NU-Horizonsat/debug_board/debug_board.kicad_pcb

## KiCad design debug_board.kicad_pcb (2024-07-23)

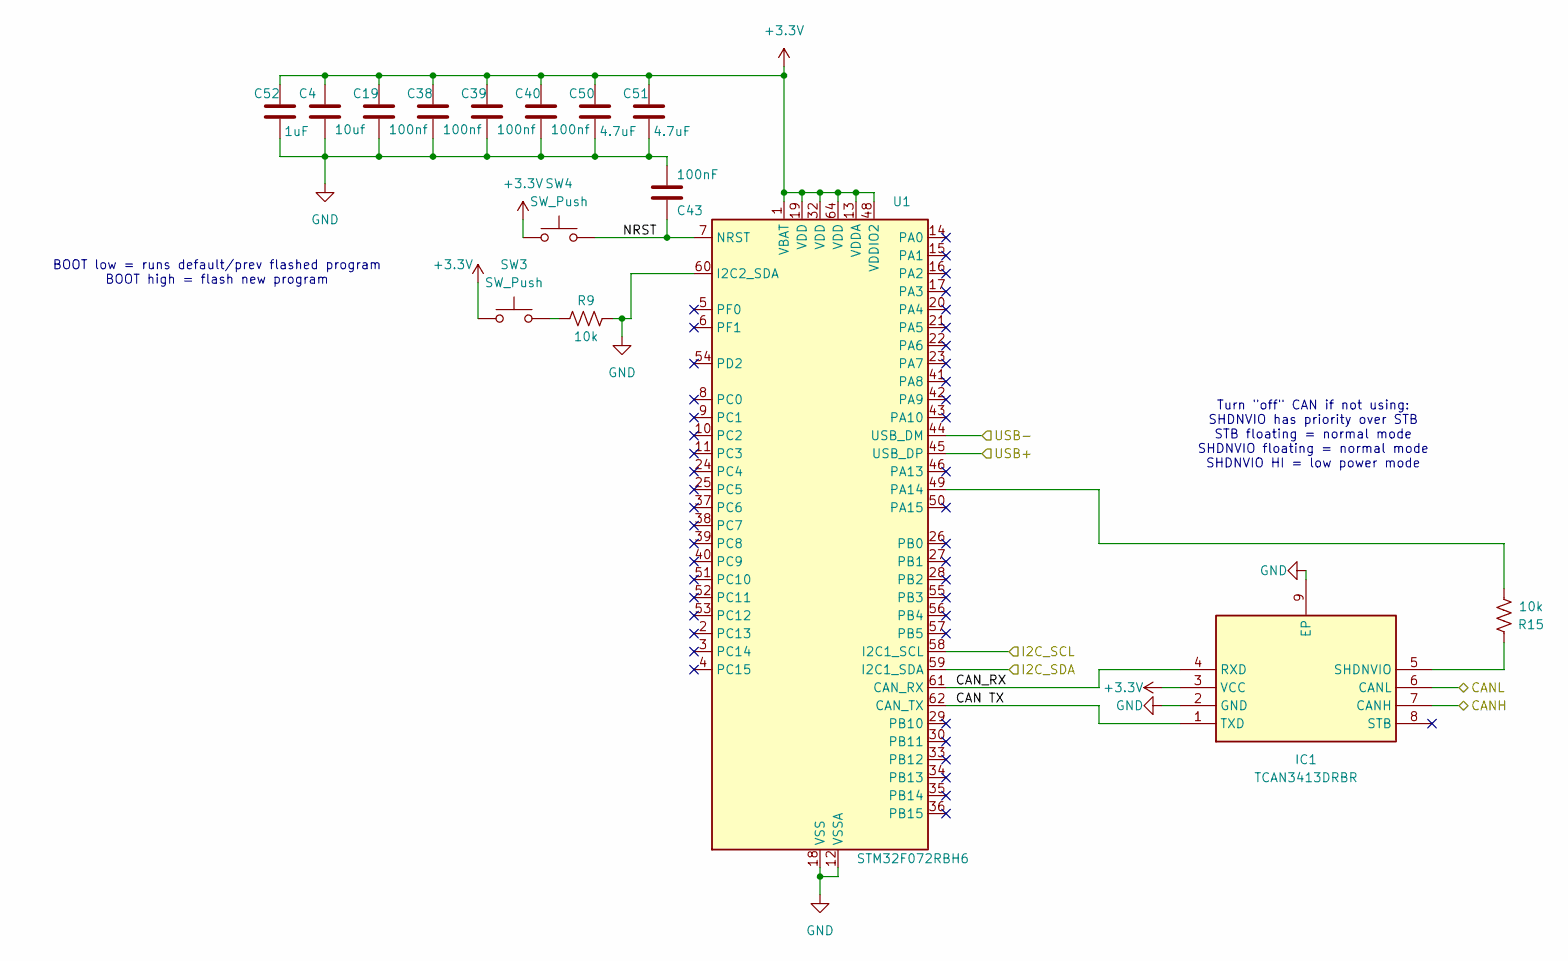
[picture p1: schematic STM32.kicad_sch]

Parts:
C4: 10uf; C_0603_1608Metric
C19, C38, C39, C40: 100nf; C_0603_1608Metric
C43: 100nF; C_0603_1608Metric
C50, C51: 4.7uF; C_0603_1608Metric
C52: 1uF; C_0603_1608Metric
IC1: TCAN3413DRBR; SON65P300X300X100-9N-D; Mouser Part Number 595-TCAN3413DRBR
R9, R15: 10k; R_0603_1608Metric
SW3, SW4: SW_Push; SW_Push_1P1T_XKB_TS-1187A
U1: STM32F072RBH6; LQFP-64_10x10mm_P0.5mm

Connections:
+3.3V: C4.1, C19.1, C38.1, C39.1, C40.1, C50.1, C51.1, C52.1, IC1.3 (VCC), SW3.1, SW4.1, U1.1 (VBAT), U1.13 (VDDA), U1.19 (VDD), U1.32 (VDD), U1.48 (VDDIO2), U1.64 (VDD); also elsewhere on the board
/Connector/CANH: IC1.7 (CANH); also elsewhere on the board
/Connector/CANL: IC1.6 (CANL); also elsewhere on the board
/Connector/I2C_SCL: U1.58 (I2C1_SCL); also elsewhere on the board
/Connector/I2C_SDA: U1.59 (I2C1_SDA); also elsewhere on the board
/STM32/CAN TX: IC1.1 (TXD), U1.62 (CAN_TX)
/STM32/CAN_RX: IC1.4 (RXD), U1.61 (CAN_RX)
/STM32/NRST: C43.2, SW4.2, U1.7 (NRST)
/STM32/USB+: U1.45 (USB_DP); also elsewhere on the board
/STM32/USB-: U1.44 (USB_DM); also elsewhere on the board
GND: C4.2, C19.2, C38.2, C39.2, C40.2, C43.1, C50.2, C51.2, C52.2, IC1.2 (GND), IC1.9 (EP), R9.2, U1.12 (VSSA), U1.18 (VSS), U1.31 (VSS), U1.47 (VSS), U1.60 (I2C2_SDA), U1.63 (VSS); also elsewhere on the board
unnamed: IC1.5 (SHDNVIO), R15.2
unnamed: R9.1, SW3.2
unnamed: R15.1, U1.49 (PA14)

Notes on the sheet:
BOOT low = runs default/prev flashed program BOOT high = flash new program
Turn "off" CAN if not using: SHDNVIO has priority over STB STB floating = normal mode SHDNVIO floating = normal mode SHDNVIO HI = low power mode

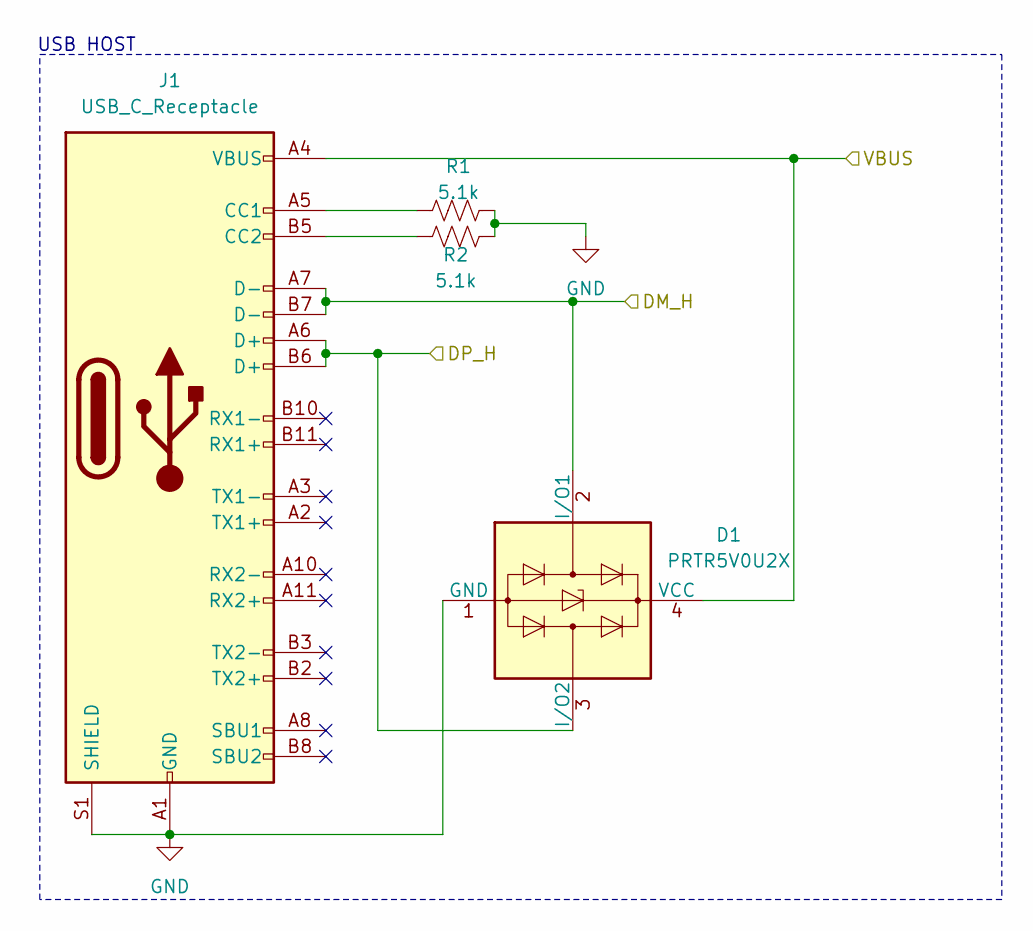
[picture p2: schematic host.kicad_sch]

Parts:
D1: PRTR5V0U2X; SOT-143
J1: USB_C_Receptacle; USB_C_Receptacle_HRO_TYPE-C-31-M-12
R1, R2: 5.1k; R_0603_1608Metric

Connections:
/USB Host/DM_H: D1.2 (I/O1), J1.A7 (D-), J1.B7 (D-); also elsewhere on the board
/USB Host/DP_H: D1.3 (I/O2), J1.A6 (D+), J1.B6 (D+); also elsewhere on the board
/USB Host/VBUS: D1.4 (VCC), J1.A4 (VBUS), J1.A9 (VBUS), J1.B4 (VBUS), J1.B9 (VBUS); also elsewhere on the board
GND: D1.1 (GND), J1.A1 (GND), J1.A12 (GND), J1.B1 (GND), J1.B12 (GND), J1.S1 (SHIELD), R1.2, R2.2; also elsewhere on the board
unnamed: J1.A5 (CC1), R1.1
unnamed: J1.B5 (CC2), R2.1

Notes on the sheet:
USB HOST

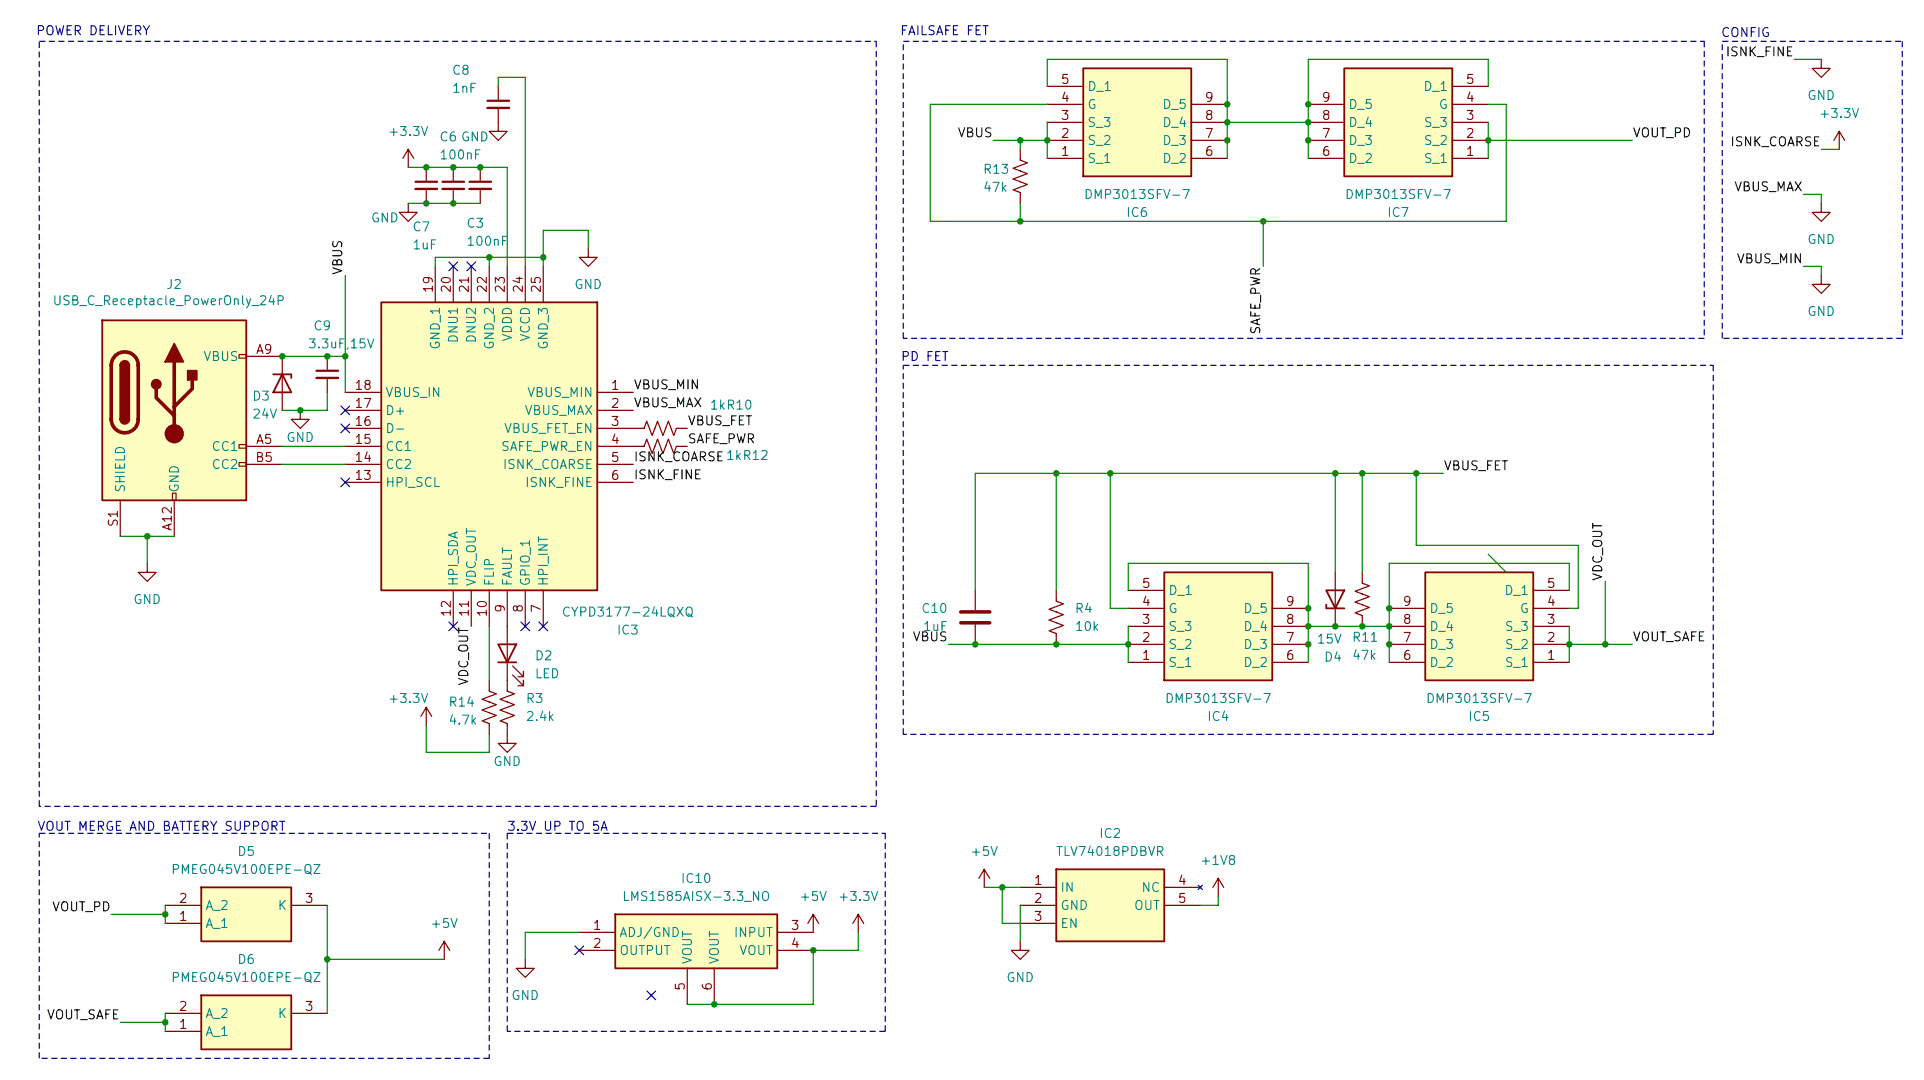
[picture p3: schematic power.kicad_sch]

Parts:
C3, C6: 100nF; C_0603_1608Metric
C7, C10: 1uF; C_0603_1608Metric
C8: 1nF; C_0603_1608Metric
C9: 3.3uF,15V; C_0603_1608Metric
D2: LED; LED_0603_1608Metric
D3: 24V; D_SOD-323_HandSoldering
D4: 15V; SODFL2513X100N
D5, D6: PMEG045V100EPE-QZ; PMEG045V100EPEQZ; Mouser Part Number 771-PMEG045V100EPEQZ
IC2: TLV74018PDBVR; SOT95P280X145-5N; Mouser Part Number 595-TLV74018PDBVR
IC3: CYPD3177-24LQXQ; QFN50P400X400X60-25N-D; Mouser Part Number 727-CYPD3177-24LQXQ
IC4, IC5, IC6, IC7: DMP3013SFV-7; DMP3036SFV7; Mouser Part Number 621-DMP3013SFV-7
IC10: LMS1585AISX-3.3_NO; KTT0003B; Mouser Part Number 595-LMS1585AISX33/NO
J2: USB_C_Receptacle_PowerOnly_24P; USB_C_Receptacle_GCT_USB4135-GF-A_6P_TopMnt_Horizontal
R3: 2.4k; R_0603_1608Metric
R4: 10k; R_0603_1608Metric
R10, R12: 1k; R_0603_1608Metric
R11, R13: 47k; R_0603_1608Metric
R14: 4.7k; R_0603_1608Metric

Connections:
+1V8: IC2.5 (OUT); also elsewhere on the board
+3.3V: C3.1, C6.1, C7.1, IC3.5 (ISNK_COARSE), IC3.23 (VDDD), IC10.4 (VOUT), IC10.5 (VOUT), IC10.6 (VOUT), R14.2; also elsewhere on the board
+5V: D5.3 (K), D6.3 (K), IC2.1 (IN), IC2.3 (EN), IC10.3 (INPUT); also elsewhere on the board
/Power/SAFE_PWR: IC6.4 (G), IC7.4 (G), R12.2, R13.2
/Power/VBUS: C9.1, C10.2, D3.1 (K), IC3.18 (VBUS_IN), IC4.1 (S_1), IC4.2 (S_2), IC4.3 (S_3), IC6.1 (S_1), IC6.2 (S_2), IC6.3 (S_3), J2.A4 (VBUS), J2.A9 (VBUS), J2.B4 (VBUS), J2.B9 (VBUS), R4.2, R13.1
/Power/VBUS_FET: C10.1, D4.2 (A), IC4.4 (G), IC5.4 (G), R4.1, R10.2, R11.1
/Power/VDC_OUT: D6.1 (A_1), D6.2 (A_2), IC3.11 (VDC_OUT), IC5.1 (S_1), IC5.2 (S_2), IC5.3 (S_3)
/Power/VOUT_PD: D5.1 (A_1), D5.2 (A_2), IC7.1 (S_1), IC7.2 (S_2), IC7.3 (S_3)
GND: C3.2, C6.2, C7.2, C8.2, C9.2, D3.2 (A), IC2.2 (GND), IC3.1 (VBUS_MIN), IC3.2 (VBUS_MAX), IC3.6 (ISNK_FINE), IC3.19 (GND_1), IC3.22 (GND_2), IC3.25 (GND_3), IC10.1 (ADJ/GND), J2.A1 (GND), J2.A12 (GND), J2.B1 (GND), J2.B12 (GND), J2.S1 (SHIELD), R3.2; also elsewhere on the board
unnamed: D2.2 (A), IC3.9 (FAULT)
unnamed: D2.1 (K), R3.1
unnamed: D4.1 (K), IC4.5 (D_1), IC4.6 (D_2), IC4.7 (D_3), IC4.8 (D_4), IC4.9 (D_5), IC5.5 (D_1), IC5.6 (D_2), IC5.7 (D_3), IC5.8 (D_4), IC5.9 (D_5), R11.2
unnamed: IC3.15 (CC1), J2.A5 (CC1)
unnamed: IC3.14 (CC2), J2.B5 (CC2)
unnamed: IC3.10 (FLIP), R14.1
unnamed: IC3.4 (SAFE_PWR_EN), R12.1
unnamed: IC3.3 (VBUS_FET_EN), R10.1
unnamed: C8.1, IC3.24 (VCCD)
unnamed: IC6.5 (D_1), IC6.6 (D_2), IC6.7 (D_3), IC6.8 (D_4), IC6.9 (D_5), IC7.5 (D_1), IC7.6 (D_2), IC7.7 (D_3), IC7.8 (D_4), IC7.9 (D_5)

Notes on the sheet:
PD FET
POWER DELIVERY
VOUT MERGE AND BATTERY SUPPORT
CONFIG
3.3V UP TO 5A
FAILSAFE FET

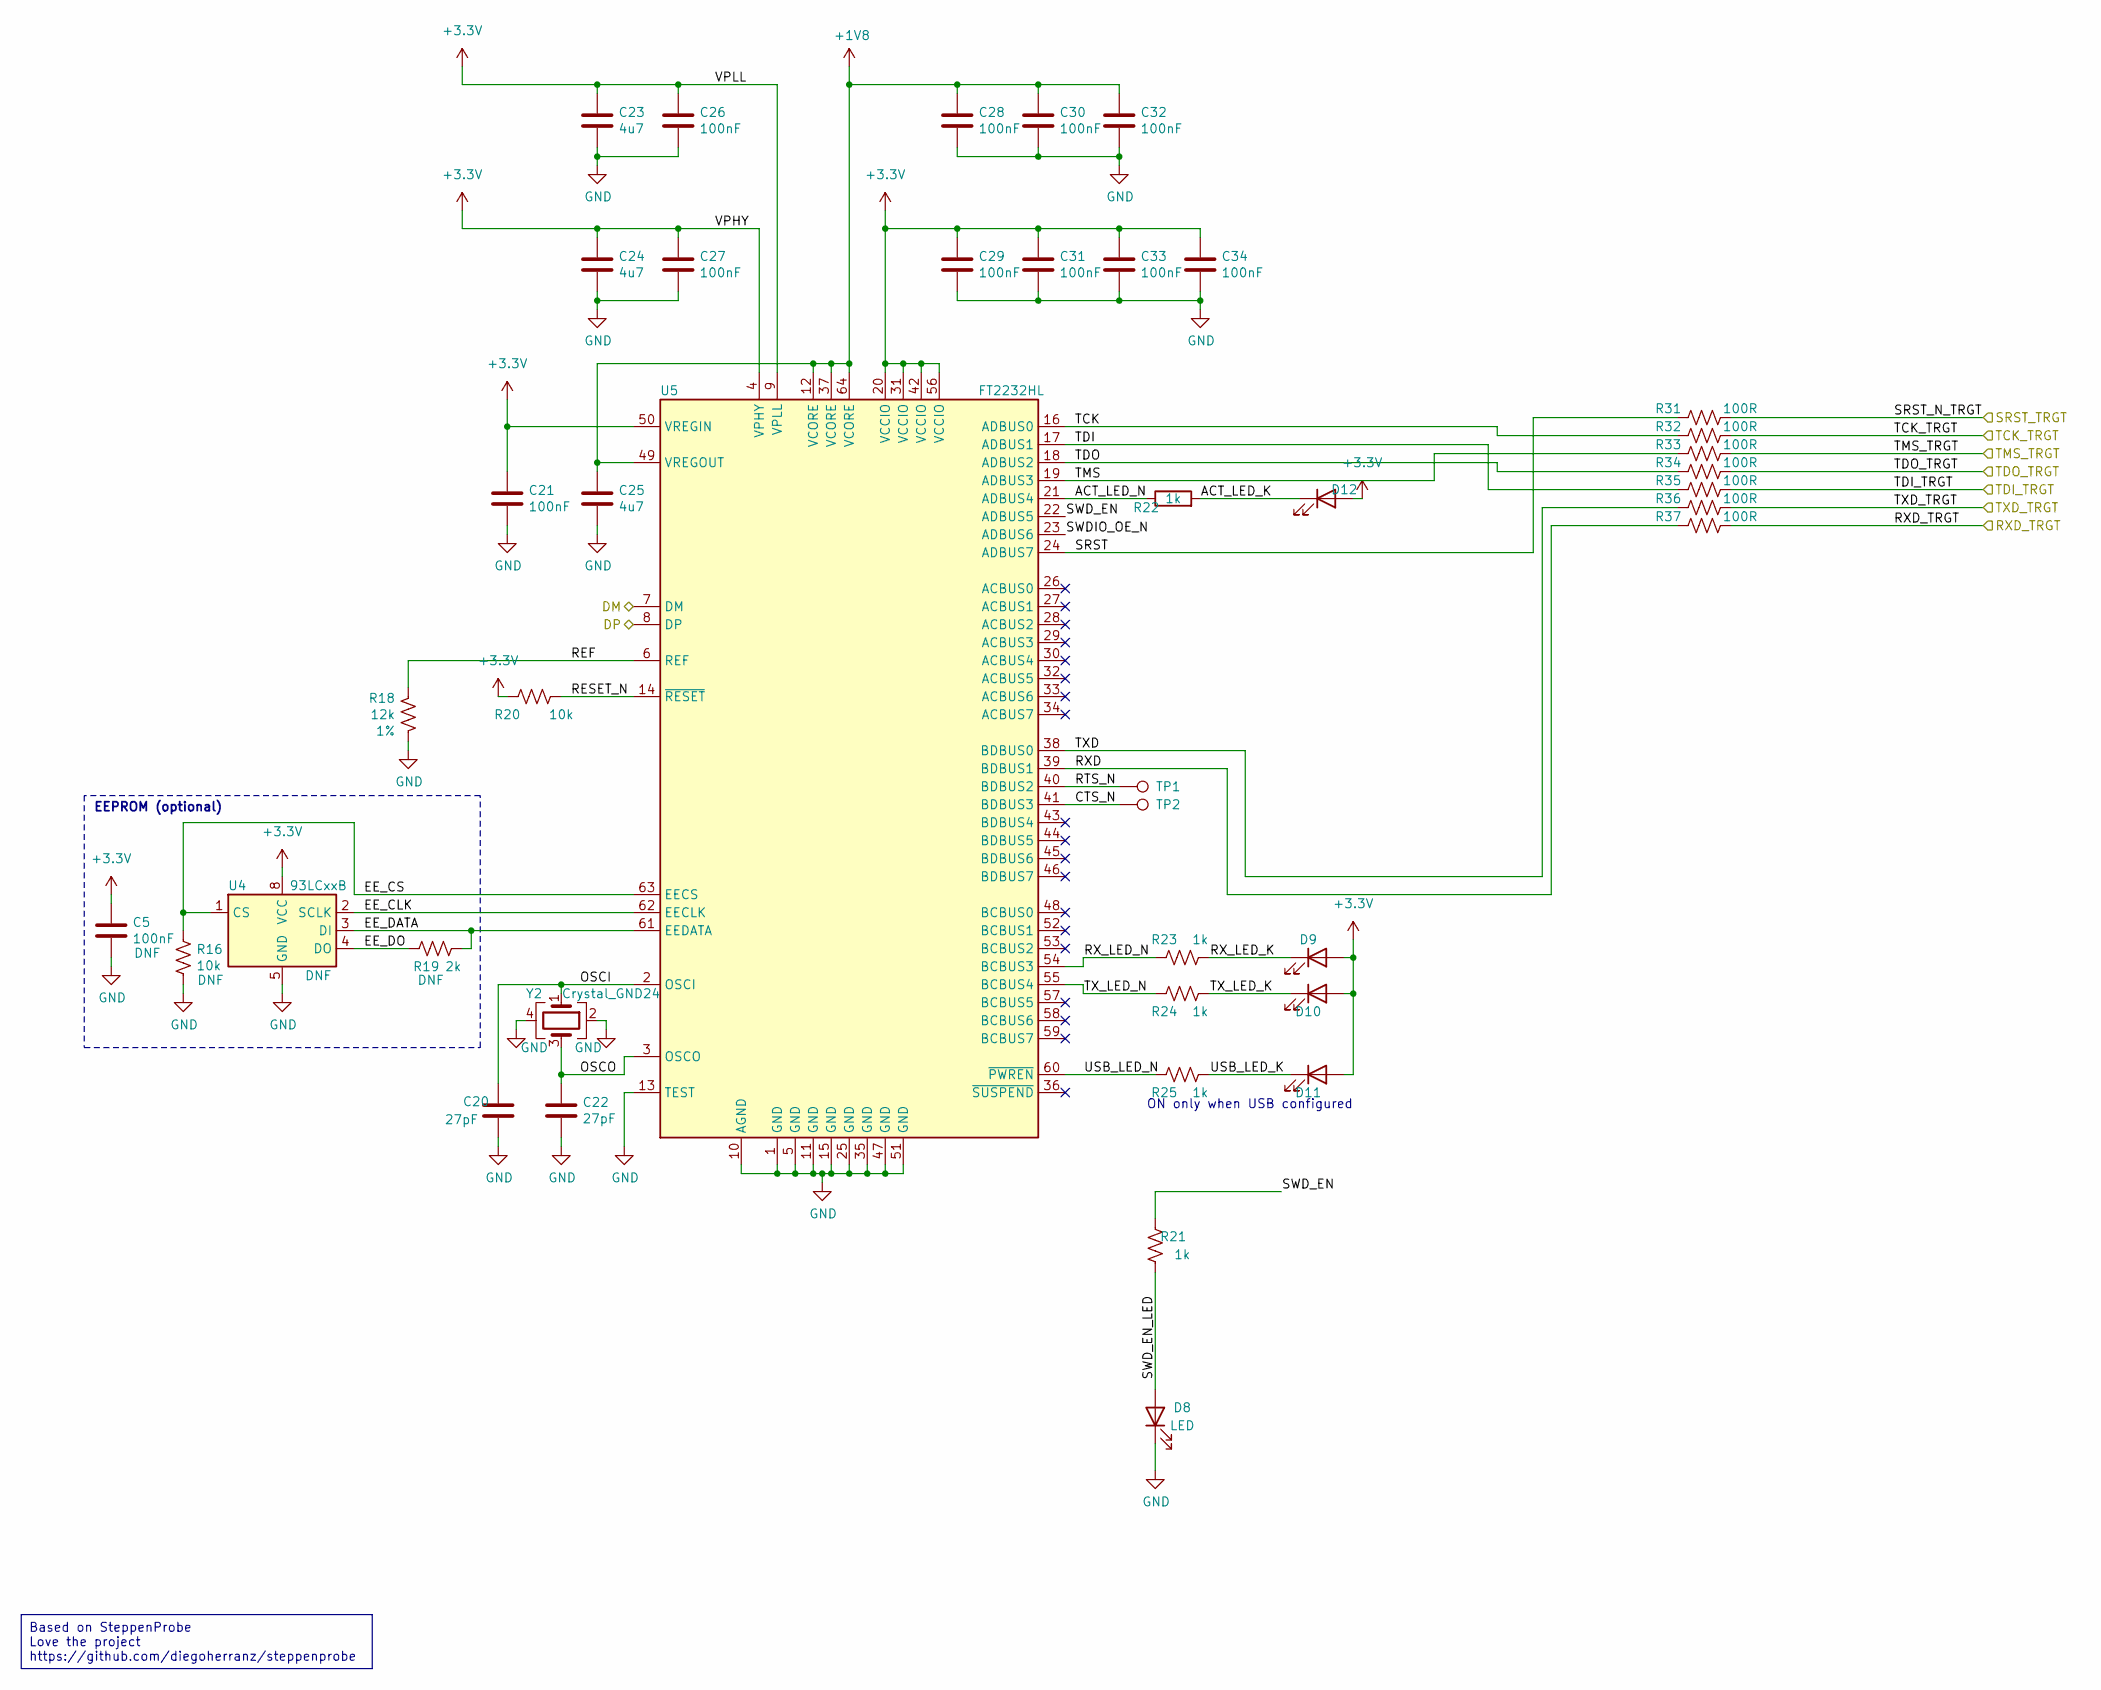
[picture p4: schematic jtag.kicad_sch]

Parts:
C5: 100nF; C_0603_1608Metric
C20, C22: 27pF; C_0603_1608Metric; Tolerance 5%; MPN C0603C270J5GAC; LCSC_PN C1656
C21, C26, C27, C28, C29, C30, C31, C32, C33, C34: 100nF; C_0603_1608Metric; Tolerance 10%; MPN CC0603KRX7R9BB104; LCSC_PN C14663
C23, C24, C25: 4u7; C_0603_1608Metric; Tolerance 10%; MPN CL10A475KO8NNNC; LCSC_PN C19666
D8, D9, D10, D11, D12: LED; LED_0603_1608Metric; MPN 19-217/GHC-YR1S2/3T; LCSC_PN C72043
R16: 10k; R_0603_1608Metric
R18: 12k; R_0603_1608Metric; Tolerance 1%; LCSC_PN C22790
R19: 2k; R_0603_1608Metric
R20: 10k; R_0603_1608Metric; Tolerance 5%; LCSC_PN C25804
R21, R22, R23, R24, R25: 1k; R_0603_1608Metric; Tolerance 5%; LCSC_PN C21190
R31, R32, R33, R34, R35, R36, R37: 100R; R_0603_1608Metric; Tolerance 5%; LCSC_PN C22775
TP1, TP2: TestPoint; TestPoint_Pad_D1.0mm
U4: 93LCxxB; SOIC-8_3.9x4.9mm_P1.27mm
U5: FT2232HL; LQFP-64_10x10mm_P0.5mm; MPN FT2232HL; LCSC_PN C27882
Y2: Crystal_GND24; Crystal_SMD_3225-4Pin_3.2x2.5mm; Tolerance 10PPM; MPN ABM8-12.000MHZ-20-B1U-T; LCSC_PN C9002

Connections:
+1V8: C25.1, C28.1, C30.1, C32.1, U5.12 (VCORE), U5.37 (VCORE), U5.49 (VREGOUT), U5.64 (VCORE); also elsewhere on the board
+3.3V: C5.1, C21.1, C23.1, C24.1, C26.1, C27.1, C29.1, C31.1, C33.1, C34.1, D9.2 (A), D10.2 (A), D11.2 (A), D12.2 (A), R20.2, U4.8 (VCC), U5.4 (VPHY), U5.9 (VPLL), U5.20 (VCCIO), U5.31 (VCCIO), U5.42 (VCCIO), U5.50 (VREGIN), U5.56 (VCCIO); also elsewhere on the board
/FTDI/ACT_LED_K: D12.1 (K), R22.2
/FTDI/ACT_LED_N: R22.1, U5.21 (ADBUS4)
/FTDI/CTS_N: TP2.1, U5.41 (BDBUS3)
/FTDI/DM: U5.7 (DM); also elsewhere on the board
/FTDI/DP: U5.8 (DP); also elsewhere on the board
/FTDI/EE_CLK: U4.2 (SCLK), U5.62 (EECLK)
/FTDI/EE_CS: R16.1, U4.1 (CS), U5.63 (EECS)
/FTDI/EE_DATA: R19.2, U4.3 (DI), U5.61 (EEDATA)
/FTDI/EE_DO: R19.1, U4.4 (DO)
/FTDI/OSCI: C20.1, U5.2 (OSCI), Y2.1
/FTDI/OSCO: C22.1, U5.3 (OSCO), Y2.3
/FTDI/REF: R18.1, U5.6 (REF)
/FTDI/RESET_N: R20.1, U5.14 (~RESET)
/FTDI/RTS_N: TP1.1, U5.40 (BDBUS2)
/FTDI/RXD: R37.1, U5.39 (BDBUS1)
/FTDI/RXD_TRGT: R37.2; also elsewhere on the board
/FTDI/RX_LED_K: D9.1 (K), R23.1
/FTDI/RX_LED_N: R23.2, U5.54 (BCBUS3)
/FTDI/SRST: R31.2, U5.24 (ADBUS7)
/FTDI/SRST_N_TRGT: R31.1; also elsewhere on the board
/FTDI/SWDIO_OE_N: U5.23 (ADBUS6)
/FTDI/SWD_EN: R21.2, U5.22 (ADBUS5)
/FTDI/SWD_EN_LED: D8.2 (A), R21.1
/FTDI/TCK: R32.2, U5.16 (ADBUS0)
/FTDI/TCK_TRGT: R32.1; also elsewhere on the board
/FTDI/TDI: R35.2, U5.17 (ADBUS1)
/FTDI/TDI_TRGT: R35.1; also elsewhere on the board
/FTDI/TDO: R34.2, U5.18 (ADBUS2)
/FTDI/TDO_TRGT: R34.1; also elsewhere on the board
/FTDI/TMS: R33.2, U5.19 (ADBUS3)
/FTDI/TMS_TRGT: R33.1; also elsewhere on the board
/FTDI/TXD: R36.2, U5.38 (BDBUS0)
/FTDI/TXD_TRGT: R36.1; also elsewhere on the board
/FTDI/TX_LED_K: D10.1 (K), R24.1
/FTDI/TX_LED_N: R24.2, U5.55 (BCBUS4)
/FTDI/USB_LED_K: D11.1 (K), R25.1
/FTDI/USB_LED_N: R25.2, U5.60 (~PWREN)
GND: C5.2, C20.2, C21.2, C22.2, C23.2, C24.2, C25.2, C26.2, C27.2, C28.2, C29.2, C30.2, C31.2, C32.2, C33.2, C34.2, D8.1 (K), R16.2, R18.2, U4.5 (GND), U5.1 (GND), U5.5 (GND), U5.10 (AGND), U5.11 (GND), U5.13 (TEST), U5.15 (GND), U5.25 (GND), U5.35 (GND), U5.47 (GND), U5.51 (GND), Y2.2, Y2.4; also elsewhere on the board

Notes on the sheet:
Based on SteppenProbe Love the project https://github.com/diegoherranz/steppenprobe
EEPROM (optional)
ON only when USB configured

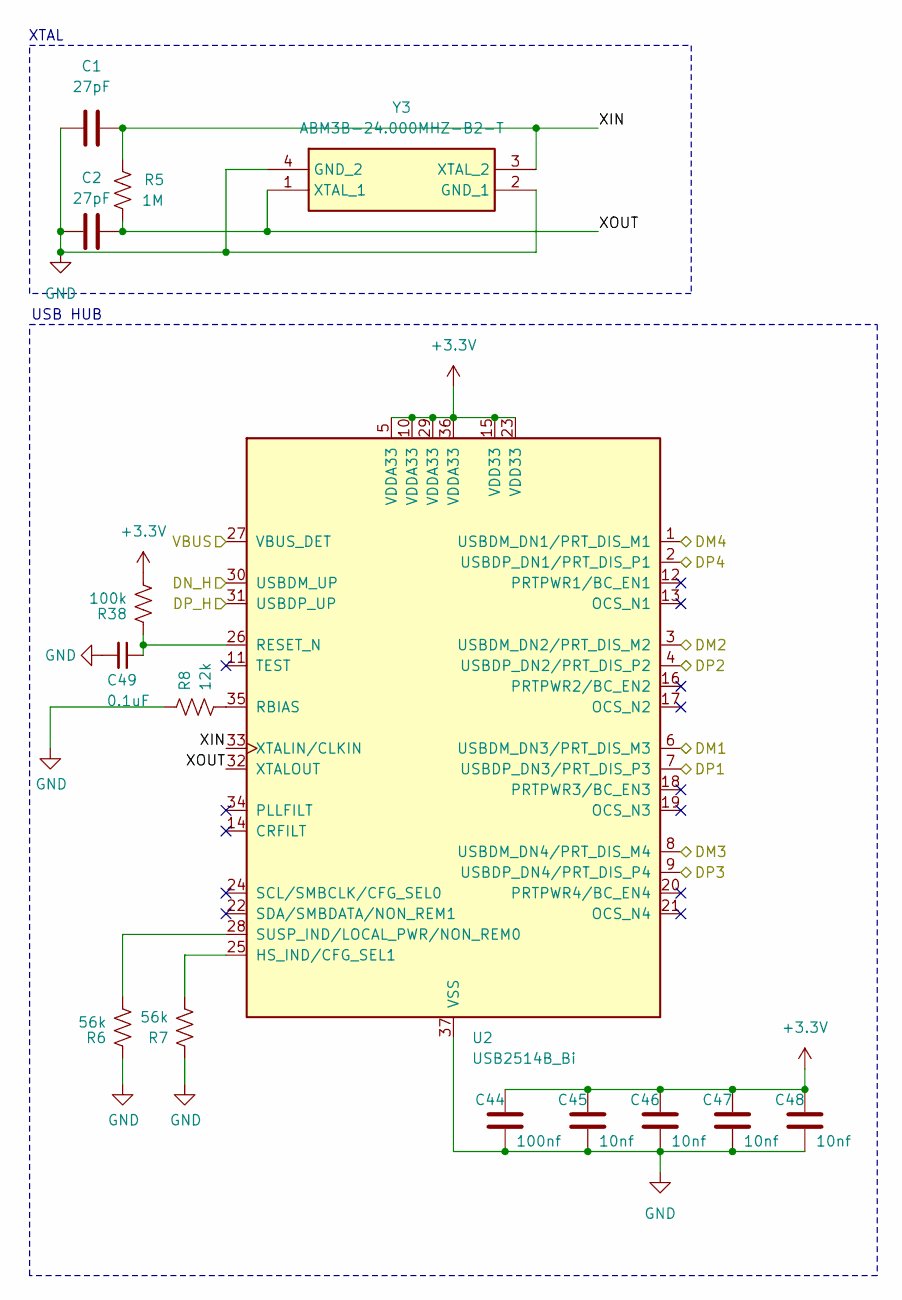
[picture p5: schematic usb_hub.kicad_sch]

Parts:
C1, C2: 27pF; C_0603_1608Metric
C44: 100nf; C_0603_1608Metric
C45, C46, C47, C48: 10nf; C_0603_1608Metric
C49: 0.1uF; C_0402_1005Metric
R5: 1M; R_0603_1608Metric
R6, R7: 56k; R_0603_1608Metric
R8: 12k; R_0603_1608Metric
R38: 100k; R_0603_1608Metric
U2: USB2514B_Bi; QFN-36-1EP_6x6mm_P0.5mm_EP3.7x3.7mm
Y3: ABM3B-24.000MHZ-B2-T; ABM3B; Mouser Part Number 815-ABM3B-24-B2

Connections:
+3.3V: C44.1, C45.1, C46.1, C47.1, C48.1, R38.2, U2.5 (VDDA33), U2.10 (VDDA33), U2.15 (VDD33), U2.23 (VDD33), U2.29 (VDDA33), U2.36 (VDDA33); also elsewhere on the board
/Connector/USB2+?: U2.9 (USBDP_DN4/PRT_DIS_P4); also elsewhere on the board
/Connector/USB2-?: U2.8 (USBDM_DN4/PRT_DIS_M4); also elsewhere on the board
/Connector/USB+: U2.4 (USBDP_DN2/PRT_DIS_P2); also elsewhere on the board
/Connector/USB-: U2.3 (USBDM_DN2/PRT_DIS_M2); also elsewhere on the board
/FTDI/DM: U2.6 (USBDM_DN3/PRT_DIS_M3); also elsewhere on the board
/FTDI/DP: U2.7 (USBDP_DN3/PRT_DIS_P3); also elsewhere on the board
/STM32/USB+: U2.2 (USBDP_DN1/PRT_DIS_P1); also elsewhere on the board
/STM32/USB-: U2.1 (USBDM_DN1/PRT_DIS_M1); also elsewhere on the board
/USB Host/DM_H: U2.30 (USBDM_UP); also elsewhere on the board
/USB Host/DP_H: U2.31 (USBDP_UP); also elsewhere on the board
/USB Host/VBUS: U2.27 (VBUS_DET); also elsewhere on the board
/USB Hub/XIN: C1.2, R5.1, U2.33 (XTALIN/CLKIN), Y3.3 (XTAL_2)
/USB Hub/XOUT: C2.2, R5.2, U2.32 (XTALOUT), Y3.1 (XTAL_1)
GND: C1.1, C2.1, C44.2, C45.2, C46.2, C47.2, C48.2, C49.2, R6.1, R7.1, R8.1, U2.37 (VSS), Y3.2 (GND_1), Y3.4 (GND_2); also elsewhere on the board
unnamed: R7.2, U2.25 (HS_IND/CFG_SEL1)
unnamed: R8.2, U2.35 (RBIAS)
unnamed: C49.1, R38.1, U2.26 (RESET_N)
unnamed: R6.2, U2.28 (SUSP_IND/LOCAL_PWR/NON_REM0)

Notes on the sheet:
XTAL
USB HUB

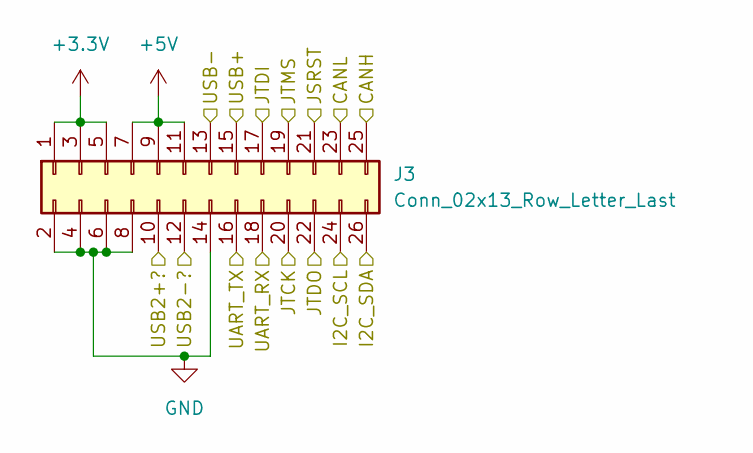
[picture p6: schematic connector.kicad_sch]

Parts:
J3: Conn_02x13_Row_Letter_Last; Samtec_HSEC8-113-X-X-DV_2x13_P0.8mm_Edge

Connections:
+3.3V: J3.1, J3.3, J3.5; also elsewhere on the board
+5V: J3.7, J3.9, J3.11; also elsewhere on the board
/Connector/CANH: J3.25; also elsewhere on the board
/Connector/CANL: J3.23; also elsewhere on the board
/Connector/I2C_SCL: J3.24; also elsewhere on the board
/Connector/I2C_SDA: J3.26; also elsewhere on the board
/Connector/USB2+?: J3.10; also elsewhere on the board
/Connector/USB2-?: J3.12; also elsewhere on the board
/Connector/USB+: J3.15; also elsewhere on the board
/Connector/USB-: J3.13; also elsewhere on the board
/FTDI/RXD_TRGT: J3.18; also elsewhere on the board
/FTDI/SRST_N_TRGT: J3.21; also elsewhere on the board
/FTDI/TCK_TRGT: J3.20; also elsewhere on the board
/FTDI/TDI_TRGT: J3.17; also elsewhere on the board
/FTDI/TDO_TRGT: J3.22; also elsewhere on the board
/FTDI/TMS_TRGT: J3.19; also elsewhere on the board
/FTDI/TXD_TRGT: J3.16; also elsewhere on the board
GND: J3.2, J3.4, J3.6, J3.8, J3.14; also elsewhere on the board

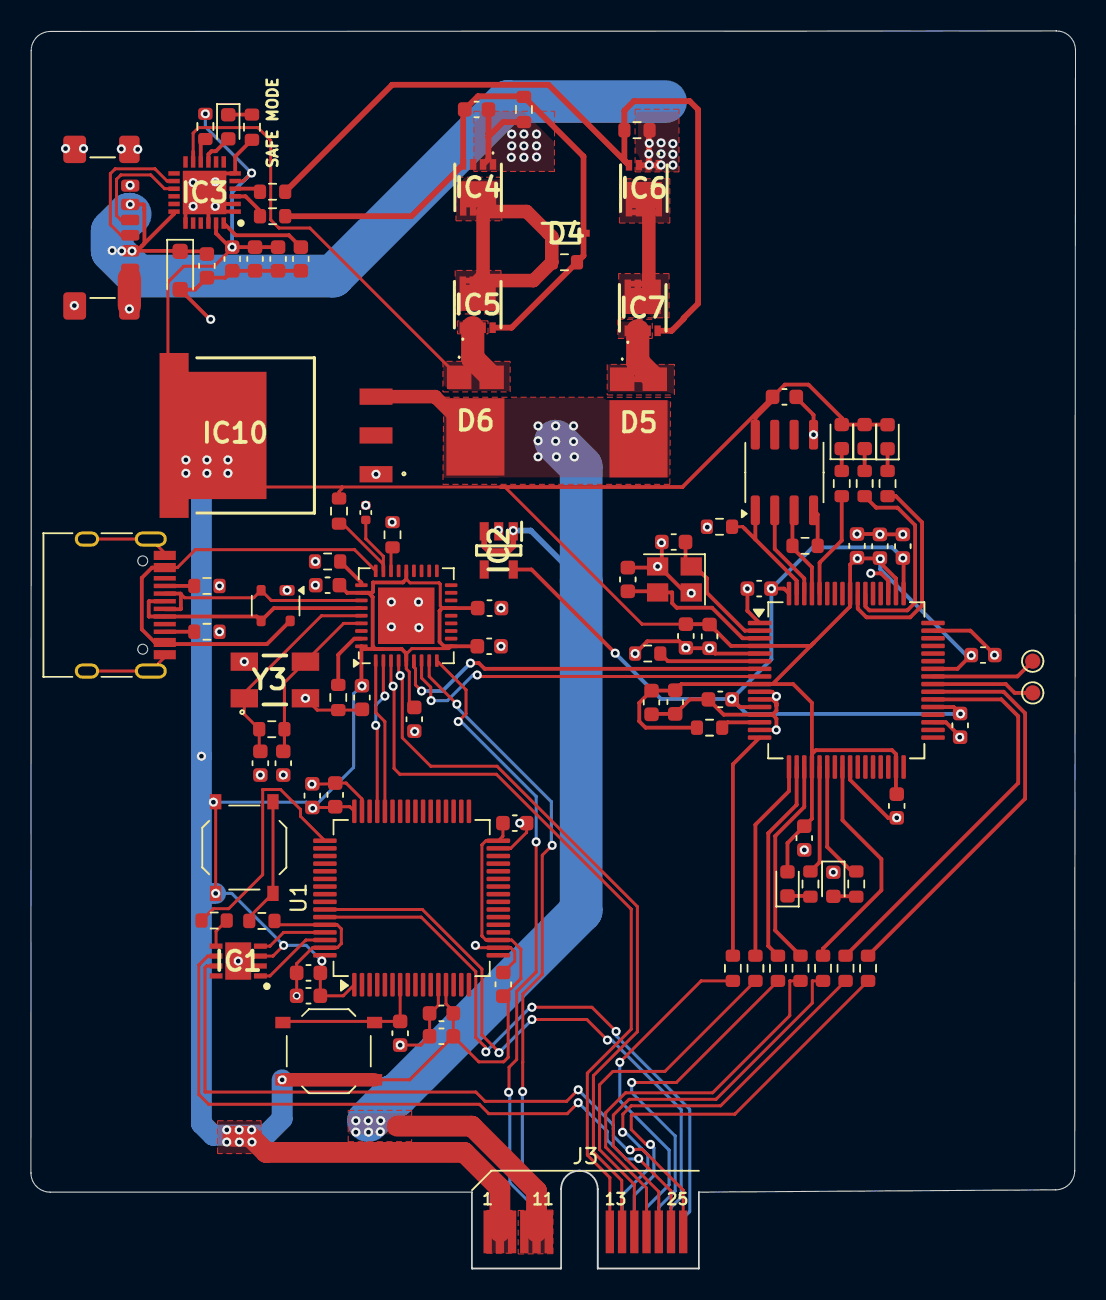
[picture p7: board debug_board.kicad_pcb from above]

Board: 2 copper layers, 68.4 x 81.0 mm, 103 parts (0 on the bottom side), 82 nets.
