NU-Horizonsat/debug_board/(commit log)

2024-06-22 Initial commit
    Need to add power capacitors, UART, and USB to edge connector. Also have to finish JTAG based on this pinout and code: https://jacobncalvert.com/blog-archive/2020/03/05/better-jtag-on-the-cheap-with-the-ft232h/
    [debug_board.kicad_pcb, debug_board.kicad_sch]
2024-06-23 changed upstream usb to not power hub. Will add PD usb source later
    [debug_board.kicad_sch]
2024-06-23 Added PD, need to work on a power mux and regulator
    [debug_board.kicad_sch]
2024-06-24 added power mux
    [power.kicad_sch]
2024-06-25 POWER IS DONE!!! need someone to check it
    [power.kicad_sch]
2024-06-27 Used steppenprobe as base for our UART and JTAG.
    [connector.kicad_sch, debug_board.kicad_sch, host.kicad_sch, jtag.kicad_sch, power.kicad_sch, usb_hub.kicad_sch]
2024-06-28 updated edge connector
    [connector.kicad_sch, debug_board.kicad_sch, jtag.kicad_sch, usb_hub.kicad_sch]
2024-07-04 renamed i2c
    [connector.kicad_sch, debug_board.kicad_sch]
2024-07-05 STM32 schematic
    [STM32.kicad_sch, debug_board.kicad_sch]
2024-07-05 3.3V changes and changed labels to hierarchical one's
    [STM32.kicad_sch, connector.kicad_sch]
2024-07-06 linked everything together. still need to add capacitors
    [STM32.kicad_sch, connector.kicad_sch, debug_board.kicad_sch]
2024-07-20 started pcb layout, host and usbhub done
    [STM32.kicad_sch, connector.kicad_sch, debug_board.kicad_pcb, debug_board.kicad_sch, host.kicad_sch, jtag.kicad_sch, power.kicad_sch, usb_hub.kicad_sch]
2024-07-20 routed stm32
    [STM32.kicad_sch, debug_board.kicad_pcb, debug_board.kicad_sch, power.kicad_sch, usb_hub.kicad_sch]
2024-07-23 pcb routed!!!!!!!
    [STM32.kicad_sch, connector.kicad_sch, debug_board.kicad_pcb, debug_board.kicad_sch, jtag.kicad_sch, power.kicad_sch, usb_hub.kicad_sch]
